diwou/Squeezie_-_Squeezebox_Server_Remote_Control/kicad/fab/rev0.1/bom/bom.csv

Designator | Footprint | Quantity | Value | LCSC Part #
C1, C2 | 1206 | 2 | 10µ
C10, C11, C12, C13, C14, C15, C4, C6, C7 | 0805 | 9 | 100n
C3 | 0805 | 1 | 10µ
C5 | 0805 | 1 | 1µ
D1 | 0805 | 1 | PWR
D2 | D_SMA | 1 | SS14
J1 | USB_C_Receptacle_HCTL_HC-TYPE-C-16P-01A | 1 | USB_C_Receptacle_USB2.0_16P
J2 | PinSocket_1x14_P2.54mm_Vertical | 1 | ILI9488 Display
R1 | 0805 | 1 | 1k
R10, R4, R5, R6, R7, R8, R9 | 0805 | 7 | 10k
R2, R3 | 0805 | 2 | 5.1k
SW1 | SWITCH_FSMARA | 1 | Boot
SW2 | SWITCH_FSMARA | 1 | Reset
SW3 | SWITCH_FSMARA | 1 | Prev
SW4 | SWITCH_FSMARA | 1 | Next
SW5 | SWITCH_FSMARA | 1 | Play
SW6 | SWITCH_FSMARA | 1 | Vol-
SW7 | SWITCH_FSMARA | 1 | Vol+
SW8 | SWITCH_FSMARA | 1 | Mute
U1 | SOT-223-3_TabPin2 | 1 | TLV76133DCY
U2 | ESP32-S3-WROOM-1 | 1 | ESP32-S3-WROOM-1
