diwou/Squeezie_-_Squeezebox_Server_Remote_Control/(list of files, drawings)

Other design files:
kicad/source/freerouting.dsn
kicad/source/temp-freerouting.dsn
