diwou/Squeezie_-_Squeezebox_Server_Remote_Control/kicad/source/Squeezie.kicad_pcb

## KiCad design kicad/source/Squeezie.kicad_pcb (2026-04-23)

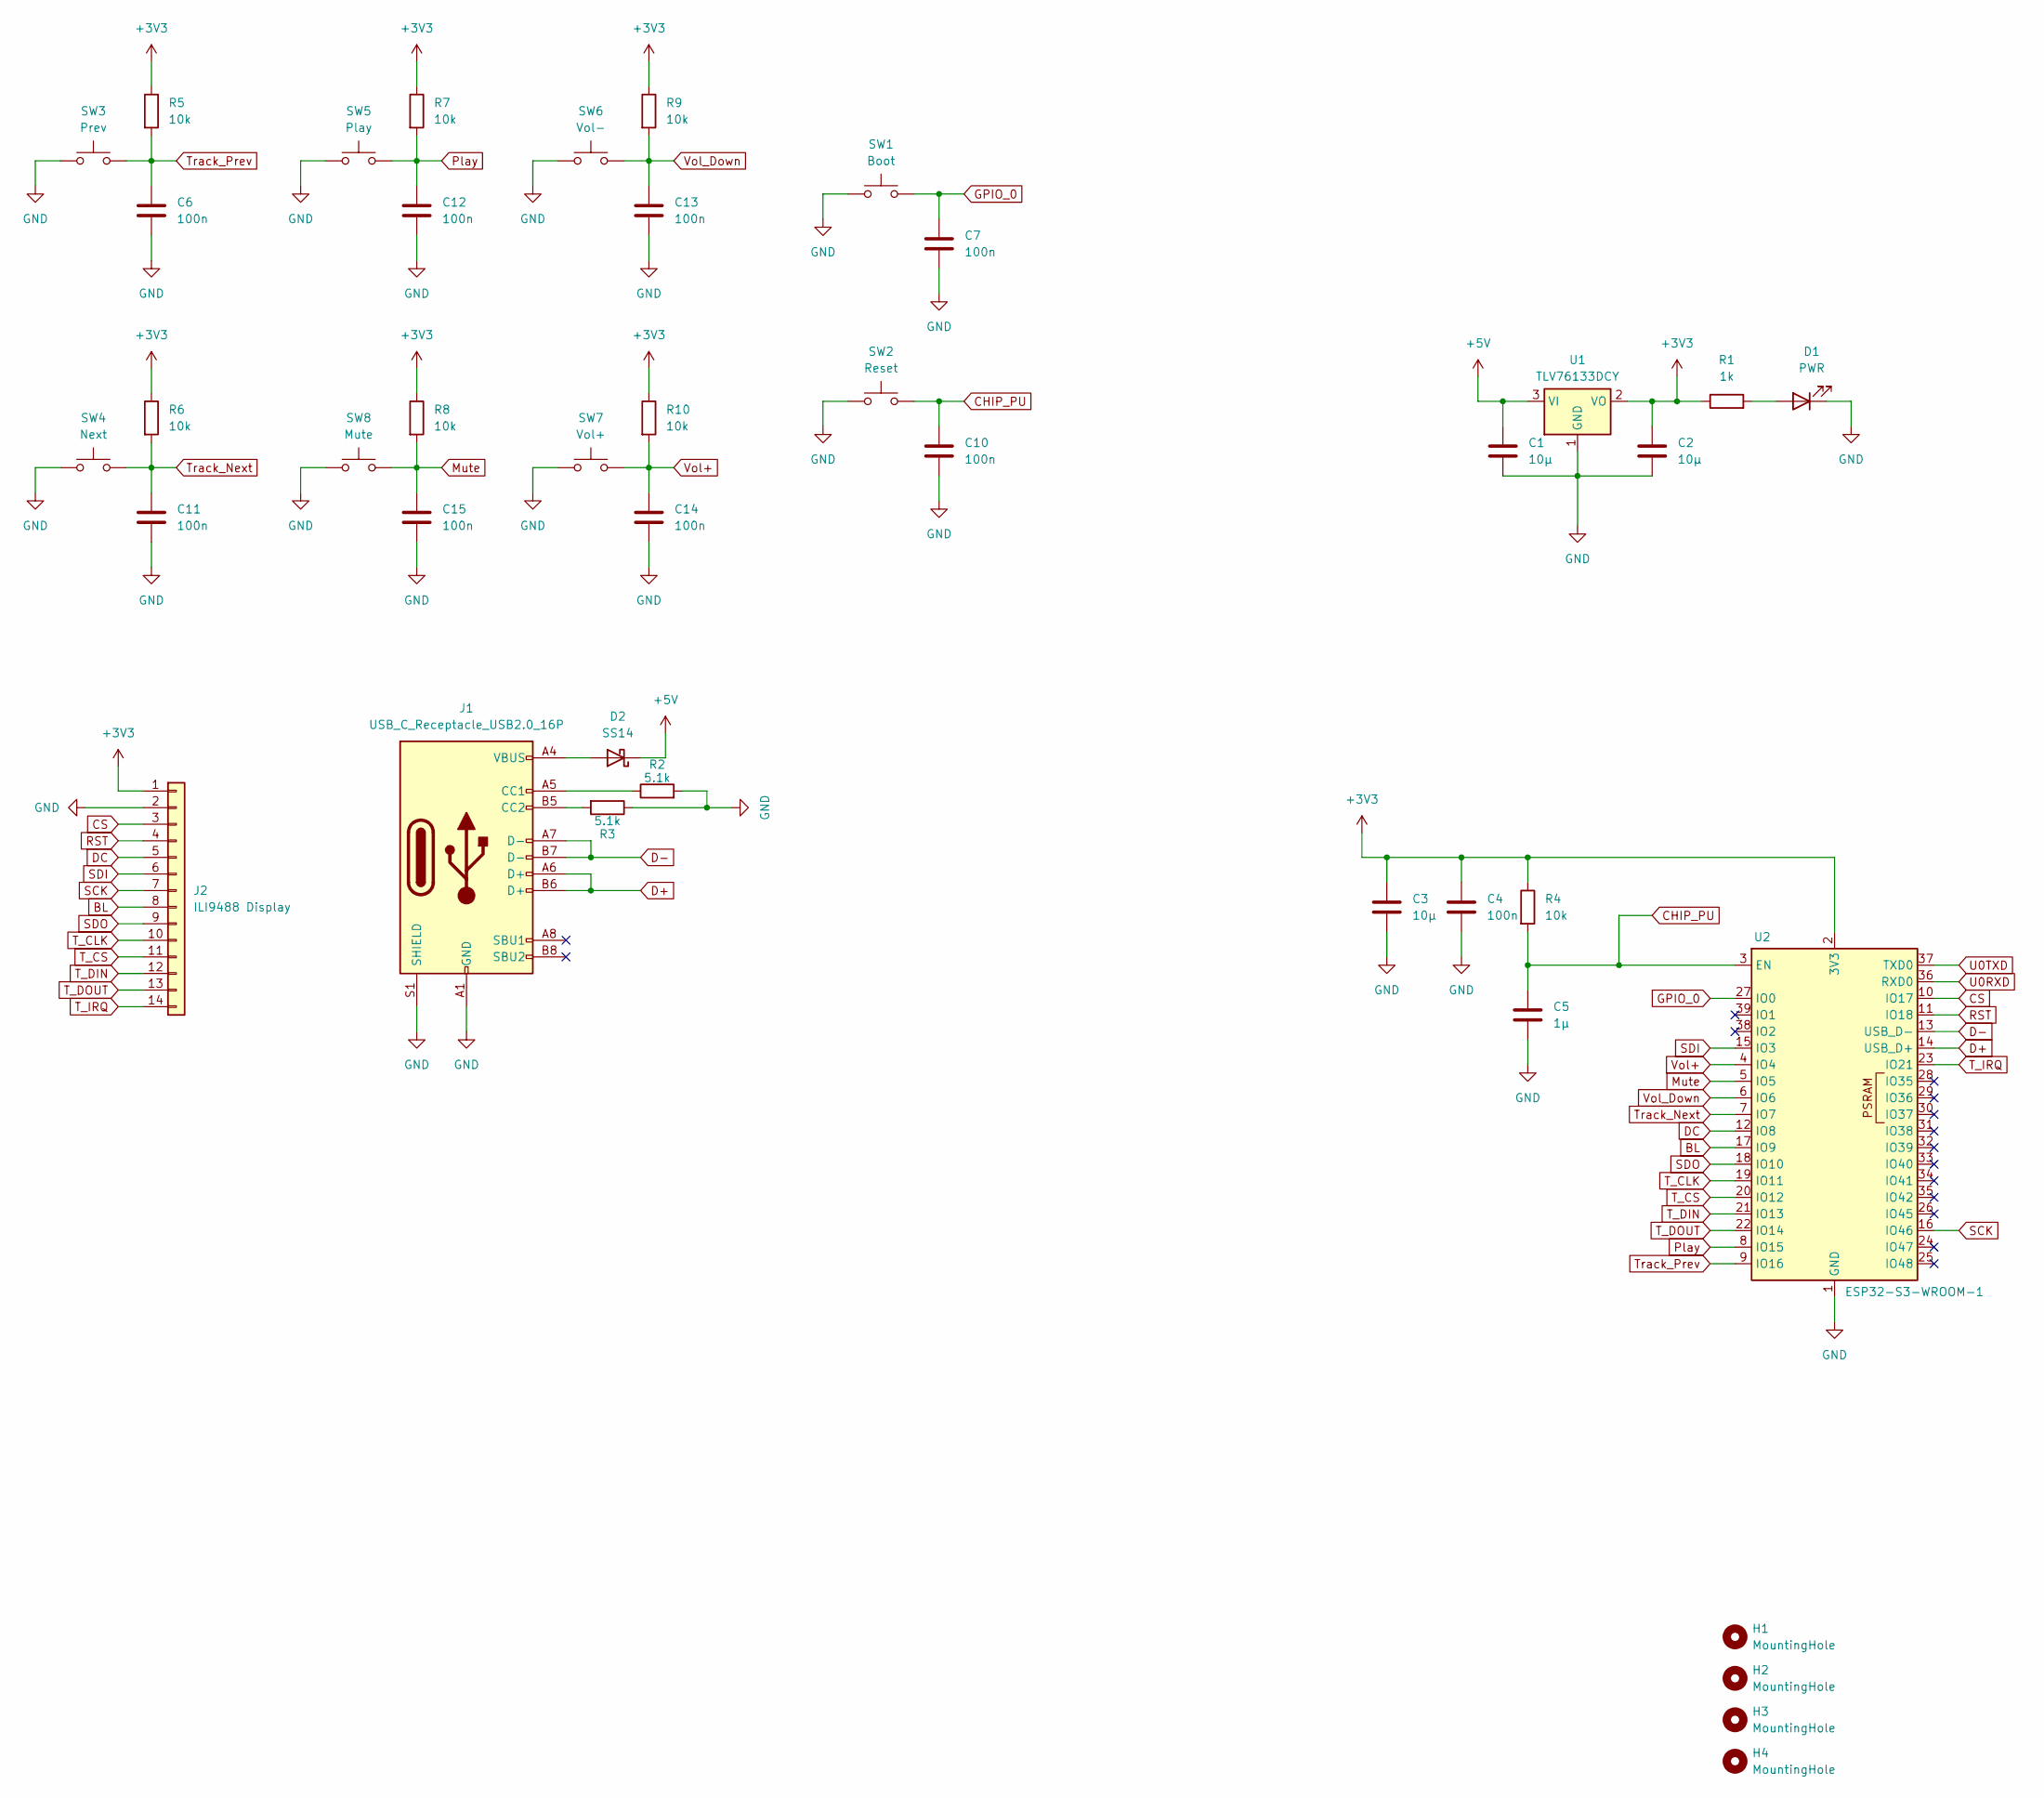
[picture p4: schematic Squeezie.kicad_sch, "Squeezie" Squeezeboxserver Control]

Parts:
C1, C2: 10µ; C_1206_3216Metric_Pad1.33x1.80mm_HandSolder
C3: 10µ; C_0805_2012Metric_Pad1.18x1.45mm_HandSolder
C4, C6, C7, C10, C11, C12, C13, C14, C15: 100n; C_0805_2012Metric_Pad1.18x1.45mm_HandSolder
C5: 1µ; C_0805_2012Metric_Pad1.18x1.45mm_HandSolder
D1: PWR; LED_0805_2012Metric_Pad1.15x1.40mm_HandSolder
D2: SS14; D_SMA
H1, H2, H3, H4: MountingHole; MountingHole_3.5mm
J1: USB_C_Receptacle_USB2.0_16P; USB_C_Receptacle_HCTL_HC-TYPE-C-16P-01A
J2: ILI9488 Display; PinSocket_1x14_P2.54mm_Vertical
R1: 1k; R_0805_2012Metric_Pad1.20x1.40mm_HandSolder
R2, R3: 5.1k; R_0805_2012Metric_Pad1.20x1.40mm_HandSolder
R4, R5, R6, R7, R8, R9, R10: 10k; R_0805_2012Metric_Pad1.20x1.40mm_HandSolder
SW1: Boot; SWITCH_FSMARA
SW2: Reset; SWITCH_FSMARA
SW3: Prev; SWITCH_FSMARA
SW4: Next; SWITCH_FSMARA
SW5: Play; SWITCH_FSMARA
SW6: Vol-; SWITCH_FSMARA
SW7: Vol+; SWITCH_FSMARA
SW8: Mute; SWITCH_FSMARA
U1: TLV76133DCY; SOT-223-3_TabPin2
U2: ESP32-S3-WROOM-1

Connections:
+3V3: C2.1, C3.1, C4.1, J2.1, R1.1, R4.1, R5.1, R6.1, R7.1, R8.1, R9.1, R10.1, U1.2 (VO), U2.2 (3V3)
+5V: C1.1, D2.1 (K), U1.3 (VI)
BL: J2.8, U2.17 (IO9)
CHIP_PU: C5.1, C10.1, R4.2, SW2.2, U2.3 (EN)
CS: J2.3, U2.10 (IO17)
D+: J1.A6 (D+), J1.B6 (D+), U2.14 (USB_D+)
D-: J1.A7 (D-), J1.B7 (D-), U2.13 (USB_D-)
DC: J2.5, U2.12 (IO8)
GND: C1.2, C2.2, C3.2, C4.2, C5.2, C6.2, C7.2, C10.2, C11.2, C12.2, C13.2, C14.2, C15.2, D1.1 (K), J1.A1 (GND), J1.A12 (GND), J1.B1 (GND), J1.B12 (GND), J1.S1 (SHIELD), J2.2, R2.2, R3.1, SW1.1, SW1.GND, SW2.1, SW2.GND, SW3.1, SW3.GND, SW4.1, SW4.GND, SW5.1, SW5.GND, SW6.1, SW6.GND, SW7.1, SW7.GND, SW8.1, SW8.GND, U1.1 (GND), U2.1 (GND), U2.40 (GND), U2.41 (GND)
GPIO_0: C7.1, SW1.2, U2.27 (IO0)
Mute: C15.1, R8.2, SW8.2, U2.5 (IO5)
unnamed: D1.2 (A), R1.2
unnamed: D2.2 (A), J1.A4 (VBUS), J1.A9 (VBUS), J1.B4 (VBUS), J1.B9 (VBUS)
unnamed: J1.A5 (CC1), R2.1
unnamed: J1.B5 (CC2), R3.2
Play: C12.1, R7.2, SW5.2, U2.8 (IO15)
RST: J2.4, U2.11 (IO18)
SCK: J2.7, U2.16 (IO46)
SDI: J2.6, U2.15 (IO3)
SDO: J2.9, U2.18 (IO10)
T_CLK: J2.10, U2.19 (IO11)
T_CS: J2.11, U2.20 (IO12)
T_DIN: J2.12, U2.21 (IO13)
T_DOUT: J2.13, U2.22 (IO14)
T_IRQ: J2.14, U2.23 (IO21)
Track_Next: C11.1, R6.2, SW4.2, U2.7 (IO7)
Track_Prev: C6.1, R5.2, SW3.2, U2.9 (IO16)
U0RXD: U2.36 (RXD0)
U0TXD: U2.37 (TXD0)
Vol+: C14.1, R10.2, SW7.2, U2.4 (IO4)
Vol_Down: C13.1, R9.2, SW6.2, U2.6 (IO6)

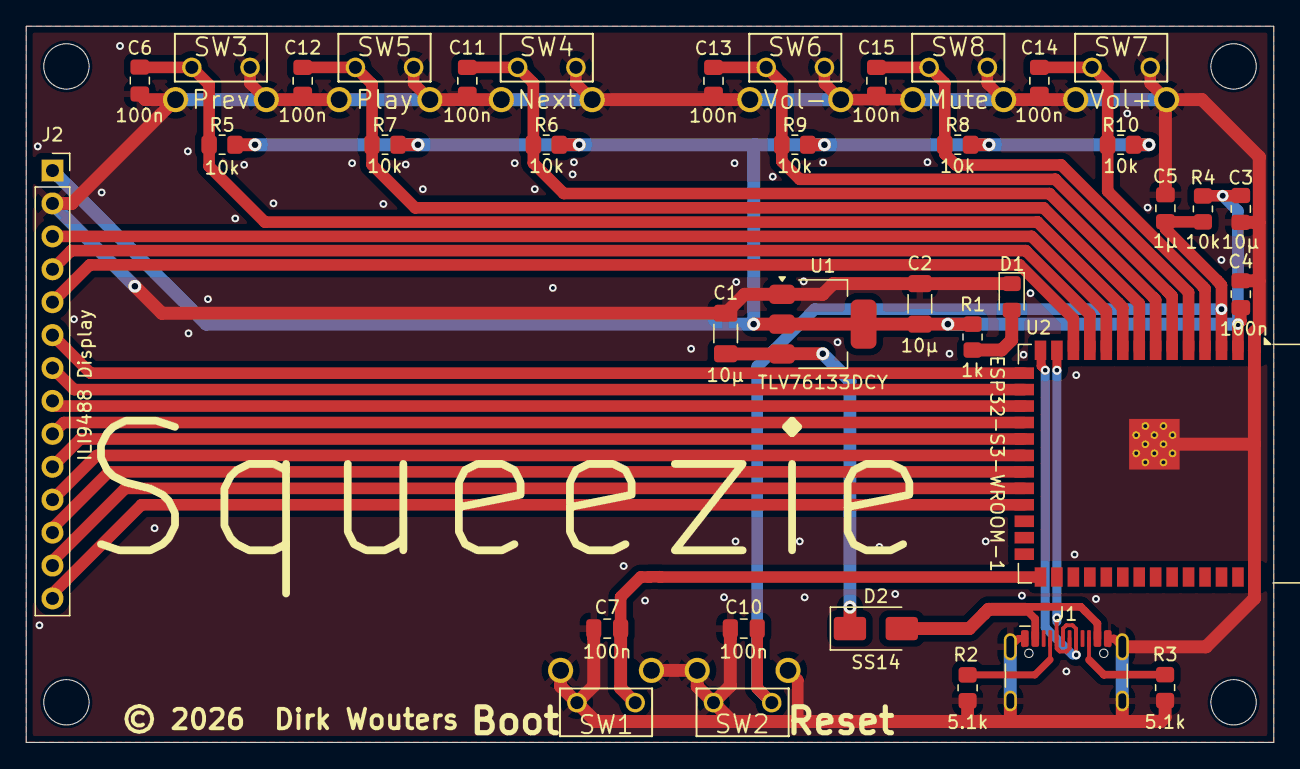
[picture p5: board Squeezie.kicad_pcb from above]

Board: 2 copper layers, 96.3 x 55.3 mm, 41 parts (0 on the bottom side), 29 nets.
