diwou/Squeezie_-_Squeezebox_Server_Remote_Control/suppress_lib_warnings.py

Import("env")

def suppress_warnings(env, node):
    return env.Object(
        node,
        CCFLAGS=[f for f in env["CCFLAGS"] if f not in ["-Wall", "-Wextra"]] + ["-w"],
    )

env.AddBuildMiddleware(suppress_warnings, "**/LovyanGFX/**")
