diwou/Squeezie_-_Squeezebox_Server_Remote_Control/(commit log)

2026-04-05 Initial commit: ESP32-S3 Squeezebox remote control
    ESP32-S3-WROOM1-N16R8 mit ILI9488 3.5" Touchdisplay (LovyanGFX),
    ESPAsyncWebServer, Lyrion/Squeezebox API-Anbindung (in Arbeit).
    Lizenz: CC BY-NC-SA 4.0
2026-04-05 Factory Reset via BOOT-Button
    [config.h, display.cpp, display.h, main.cpp, webserver.cpp, webserver.h]
2026-04-06 fix: Lautstärke-Rundung, Cover-Versionierung, OTA-Throttle, PSRAM-Flag
    - Lautstärke 16% wurde durch Ganzzahl-Division übersprungen → roundf()
    - Cover-URL enthält jetzt ?v=N Counter für zuverlässige Ajax-Aktualisierung
    - OTA-Display-Update auf einmal pro Prozentpunkt gedrosselt (war ~1000×/Upload)
    - -DBOARD_HAS_PSRAM in platformio.ini ergänzt (ESP32-S3-WROOM1 N16R8)
    [display.cpp, webserver.cpp]
2026-04-11 Fix LMS mute handling and add cspell setup
    [display.cpp, squeezeapi.cpp, squeezeapi.h, webserver.cpp]
2026-04-20 Fix cover stability and document 0.4.2
    [display.cpp, squeezeapi.cpp]
2026-04-20 Unify development versioning and fix prefetch
    [config.h, display.cpp, webserver.cpp]
2026-04-22 fix: Bedienung reaktionsschneller machen
    [config.h, display.cpp, main.cpp, squeezeapi.cpp, webserver.cpp, webserver.h]
2026-04-22 fix: externe Lautstärkeänderungen stabilisieren
    [webserver.cpp]
2026-04-22 fix: Sync-Player absolut nachführen
    [squeezeapi.cpp, squeezeapi.h, webserver.cpp]
2026-04-23 docs: KiCad-Squeezie im HUB75-Schema ablegen
    [Squeezie.kicad_pcb, Squeezie.kicad_sch, bom.csv, designators.csv, freerouting.dsn, positions.csv, temp-freerouting.dsn]
2026-04-23 docs: Changelog-Referenz für KiCad-Import ergänzen
2026-04-25 fix: Cover-Download und Regeln stabilisieren
    [config.h, display.cpp]
2026-04-29 feat: Code-Review-Punkte umgesetzt
    - display.cpp in 4 Module aufgeteilt (display_draw, display_touch,
    display_cover, display_screens) + interner Header display_intern.h
    - HW-Watchdog (esp_task_wdt_init) in setup() aktiviert
    - Doxygen-Kommentare zu allen öffentlichen API-Headern ergänzt
    - OTA-Passwortschutz über config.h (OTA_PASSWORD) aktiviert
    - NVS-Kalibrierungsdaten: Namespace-Konflikt behoben
    ("touch" -> NVS_NAMESPACE "squeezie")
    - abs()-Aufruf in squeezeVolumeFromLms() dokumentiert
    - Leere Platzhalter-Readmes gelöscht
    - Kommentar zu LovyanGFX@1.1.12-Pinning in platformio.ini
    - Touch-Pin-Defines in config.h zentralisiert
    - cspell.json um deutsche Doxygen-Wörter ergänzt
    Referen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
    [config.h, display.cpp, display.h, display_cover.cpp, display_draw.cpp, display_intern.h, display_screens.cpp, display_touch.cpp]
2026-04-29 fix: Watchdog-Bootloop durch fehlendes Feeding behoben
    Der HW-Watchdog (esp_task_wdt_init(10, true)) führte zu einem Bootloop,
    weil loop() und coverDlTask() den Watchdog nicht regelmässig feedeten.
    - esp_task_wdt_add(nullptr) + esp_task_wdt_reset() in loop()
    - esp_task_wdt_reset() während readHttpBody() (HTTP-Download)
    - esp_task_wdt_reset() nach HTTP-Download in coverDlTask()
    Referenz: watchdog-bootloop-20260429
    [display_cover.cpp, main.cpp]
2026-04-29 fix: Cover-Download-Task-Handle und Watchdog-Bootloop endgültig behoben
    - in coverDlTask() entfernt: das Task-Handle
    bleibt erhalten, sodass displayPreloadCover() weiterhin Notifications
    senden kann (bisher nur erster Cover-Download funktionierte).
    - coverDlTask() und prefetchTask() auf ulTaskNotifyTake mit 2s-Timeout
    umgestellt: blockierte Tasks mit esp_task_wdt_add() führten nach 10s
    zu Watchdog-Reset → ESP-Reboot-Loop.
    - esp_task_wdt_reset() vor http.begin()/http.GET() ergänzt: ohne Feeding
    während HTTP-Connect löste der Watchdog bei langsamen Verbindungen aus.
    - Automatischer Retry für fehlgeschlagene Cover-Downloads in coverDlTask().
    - displayUpdatePlayer() in display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
    [display_cover.cpp, display_screens.cpp]
2026-04-29 fix: Prefetch vollständig entfernt und Cover-Wechsel-Dedup repariert
    - Prefetch-Mechanismus komplett entfernt (prefetchTask, displayQueuePrefetch,
    PrefetchSlot, PSRAM-Puffer, SQUEEZE_PREFETCH-Konstante), da er wiederholt
    Probleme mit konkurrierenden HTTP-Downloads und Task-Interferenzen verursachte.
    - LMS-Poll fragt nur noch aktuellen Titel ab statt SQUEEZE_PREFETCH+1 Einträge.
    - URL-Dedup in displayPreloadCover() auf URL+Key-Vergleich umgestellt:
    bisher blockierte die identische /music/current/…-URL jeden weiteren
    Cover-Download nach dem ersten Titel.
    - displayQueuePrefetch()-Aufruf aus wifiPollNow() entfernt.
    - Web-API-Positionsinterpolation zwischen LMS-Polls hinzugefügt.
    [display.cpp, display.h, display_cover.cpp, display_intern.h, display_screens.cpp, squeezeapi.cpp, squeezeapi.h, webserver.cpp]
2026-04-29 fix: OTA-Authentifizierung durch upload_flags in platformio.ini ergänzt
    - upload_flags=--auth=squeezie in der [env:…_ota]-Sektion hinzugefügt,
    damit das OTA-Passwort aus config.h beim Upload mitgesendet wird.
    - Der Code-Review hatte ArduinoOTA.setPassword() aktiviert, aber die
    platformio.ini nicht mit angepasst.
2026-04-29 fix: Single-Shot-Cover-Download wiederhergestellt (Latenz-Probleme)
    - Persistenten Notification-Task (Code-Review) rückgängig gemacht:
    displayPreloadCover() erzeugt wieder einen eigenen FreeRTOS-Task pro
    Cover-Download, der nach der Übertragung terminiert.
    - HTTP-Timeouts auf alte Werte zurückgesetzt (3000ms Gesamt, 1200ms
    pro Read), da die erhöhten Timeouts (8000ms/5000ms) Latenzen
    verursachten.
    - Persistente Task-Erzeugung aus displayInit() entfernt.
    - Watchdog-Feeds in loop() während OTA verstärkt.
    - OTA-Passwort in platformio.ini ergänzt (upload_flags).
    [display_cover.cpp, display_screens.cpp, main.cpp, webserver.cpp]
2026-04-29 fix: coverDlTask nicht mehr zum Watchdog hinzugefügt
    - esp_task_wdt_add() aus coverDlTask entfernt: der Single-Shot-Task läuft
    nur kurz (HTTP-Timeout 3s), feedt während readHttpBody() und terminiert
    sich selbst. Ein eigener Watchdog-Eintrag ist nicht nötig und verursachte
    OTA-Abbrüche (der Watchdog erwartete Feeding von einem nicht mehr
    existierenden Task).
    [display_cover.cpp]
2026-04-29 fix: Watchdog-Init nach webserverInit() verschoben
    - esp_task_wdt_init() in setup() steht jetzt erst NACH webserverInit(),
    da connectWiFi() bis zu 12 s blockieren kann (8 s + 4 s Retry).
    Der Watchdog (10 s) hätte während der WLAN-Verbindung in setup()
    einen Neustart ausgelöst.
    - Gegenmassnahme für die zyklischen Reboots und OTA-Abbrüche.
    [main.cpp]
2026-04-29 fix: ArduinoOTA-Watchdog pausieren
2026-04-29 fix: Steuerbefehle schneller priorisieren
    [display_touch.cpp, main.cpp, webserver.cpp, webserver.h]
2026-05-01 fix: OTA-Anzeige wieder sofort zeichnen
    [main.cpp, webserver.cpp]
2026-05-01 docs: Changelog-Referenzen und OTA-Fix ergänzen
2026-05-01 fix: Display-Text für türkische Glyphen fallbacken
    [display_draw.cpp, display_screens.cpp]
2026-05-01 fix: Display-Cover auf schnellen Pfad zurücksetzen
    [squeezeapi.cpp]
2026-05-01 fix: Lautstärkebuttons im Player-Screen wieder einblenden
    [display_screens.cpp]
2026-05-01 docs: Lautstärke-Buttons im Changelog ergänzen
2026-05-01 fix: Browser-Cover direkt auf 512er LMS-URL umstellen
    [webserver.cpp]
2026-05-01 fix: Browser-Cover und OTA-Layout nachziehen
    [display_screens.cpp, webserver.cpp]
2026-05-01 docs: Browser-Cover und OTA-Layout im Changelog nachziehen
2026-05-01 fix: Browser-Coverfläche auf 512px erweitern
    [webserver.cpp]
2026-05-01 fix: Browser-Cover über lokalen Proxy ausliefern
    [webserver.cpp]
2026-05-01 fix: Browser-Cover wieder direkt vom LMS laden
    [webserver.cpp]
2026-05-01 fix: Browser-Cover per Redirect auf LMS lenken
    [webserver.cpp]
2026-05-01 fix: Browser-Cover wieder direkt auf 512x512 LMS-URL
    [webserver.cpp]
2026-05-01 fix: Browser-Cover direkt aus Status-URL speisen
    [webserver.cpp]
2026-05-01 fix: Browser-Cover beim Rendern initial setzen
    [webserver.cpp]
2026-05-01 fix: Browser-Cover im Initial-HTML setzen
    [webserver.cpp]
2026-05-01 fix: Browser-Cover auf current-URL zurückführen
    [webserver.cpp]
2026-05-01 fix: Browser-Cover sichtbar laden
    [webserver.cpp]
2026-05-01 fix: Browser-Cover per JS initialisieren
    [webserver.cpp]
2026-05-01 fix: Browser-Cover wieder direkt setzen
    [webserver.cpp]
2026-05-01 fix: Browser-Cover als Overlay rendern
    [webserver.cpp]
2026-05-01 fix: Browser-Cover über Platzhalter legen
    [webserver.cpp]
2026-05-01 fix: Browser-Cover als Hintergrund laden
    [webserver.cpp]
2026-05-02 fix: Browser-Cover wieder als Proxy ausliefern
    [webserver.cpp]
2026-05-03 fix: LMS-Poll für Cover-Updates verkürzen
    [webserver.cpp]
2026-05-04 fix: Player-Screen nach Langläufen stabilisieren
    [display.cpp, display_intern.h, display_screens.cpp]
2026-05-09 fix: Cover-Downloads bei Timeout beenden
    [display_cover.cpp, webserver.cpp]
2026-05-12 fix: aktualisiere pinmapping, touch-spi und serversuche
    [LGFX_setup.h, config.h, display.cpp, squeezeapi.cpp]
2026-05-12 fix: verbessere lms discovery und erweitere hardware-tasten
    [config.h, display.cpp, display_intern.h, display_screens.cpp, main.cpp, squeezeapi.cpp, squeezeapi.h]
2026-05-12 feat: release-vorbereitung mit web-installer und discovery-fixes
    [config.h, main.cpp, squeezeapi.cpp]
2026-05-12 docs: ergänze projektbilder und web-installer-link
2026-05-19 fix(display): stabilisiere Lauftext-Rendering und zeige Uptime im Webinterface
    [display.cpp, display_draw.cpp, display_intern.h, webserver.cpp]
2026-05-19 docs(changelog): ergänze Commit-Referenzen für Lauftext und Uptime
2026-05-19 fix(lms): härte json-rpc payload und sync-member parsing
    [squeezeapi.cpp]
