diwou/Squeezie_-_Squeezebox_Server_Remote_Control/(notices)

Notices in the files:
kicad/source/Squeezie.kicad_pcb:
© 2026 Dirk Wouters
License: CC BY-NC-SA 4.0
